anarterb/SNEStoCDi/wiring.jpg

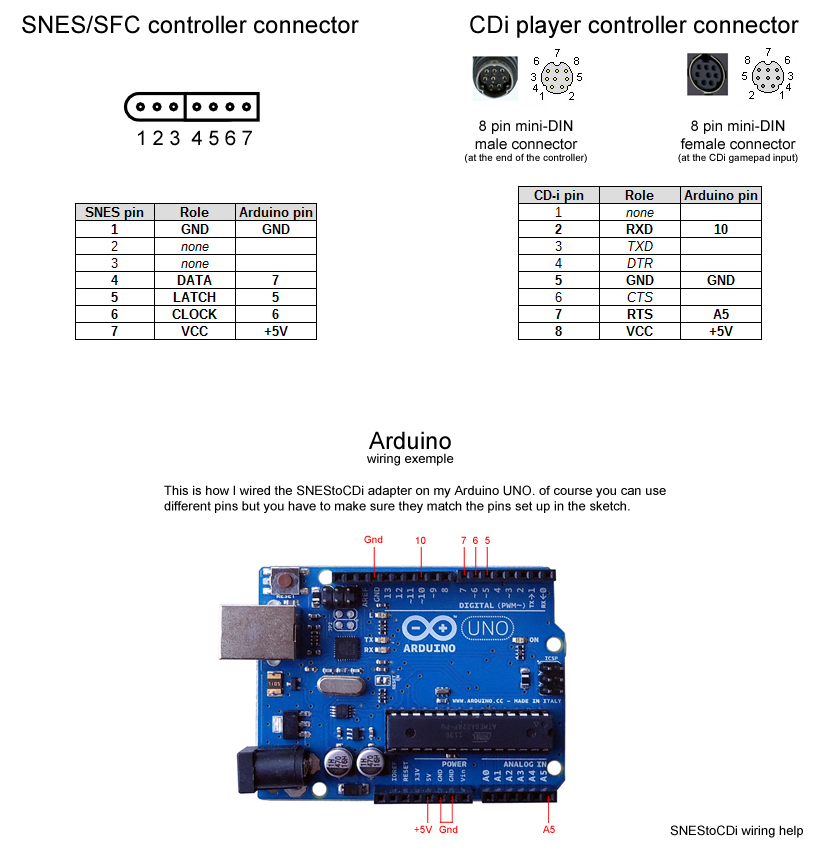
wiring.jpg
