anarterb/SNEStoCDi/(threads)

Thread 1 (2022-03-21):

Snes to cdi pad no funciona

breolou, 2022-03-21:
Hola, me llamo Breogán.
He intentado fabricar un adaptador de snes pd para la philips cdi, el caso es que no funciona... Lo he intentado varias veces, he repasado el cableado y parece que está todo bien.
Soy nuevo con el Arduino y no sé donde puede estar el error.
Un saludo y gracias.

pasmoi87, 2023-04-22:
Hello,
I have made a SNES2CDI with Arduino Pro Mini and It not works on CDI 470 and works on my CDI 210.
I made another for a guy who has a CDI 210 and it not works ?
Any ideas ?
I have also made a version RF, I will test them when I receive my Arduinos 3,3V.
Thanks.
