anarterb/SNEStoCDi/sketchSNEStoCDi.ino

/*******************************
 *
 *  File: sketchSNEStoCDi.ino
 *  Description: software for the SNEStoCDi gamepad converter (allows to use a Nintendo SNES/SFC gamepad on a Philips CDi)
 *  Author: Laurent Berta
 *  Date: 03-21-2016
 *  Version: 0.2
 *  Thanks: Rob Duarte (SNESpad library), Paul Hackmann (documentation about the CDi pointing devices)
 *  License: CC-BY 4.0 ( http://creativecommons.org/licenses/by/4.0/legalcode )
 *
 ******************************/

#include <SoftwareSerial.h>
#include <SNESpad.h>
#include <EEPROM.h>

SNESpad pad = SNESpad(5, 6, 7); // Create a SNESpad instance, change the pin values to match your wiring (latch, clock, data)
SoftwareSerial vSerial(9, 10, true); // RX, TX, inverse_logic. RX is not used here, as the CDi only communicates on the RTS line
const int RTSpin = 5; // the number of the analog pin used to receive the RTS signal from the CDi
const int ledPin = 13; // the number of the inboard LED pin

const int RTSthreshold = 328; // threshold for the CDi RTS analog detection
uint16_t btns;
bool btnRpressed = false;
int padbyte0, padbyte1, padbyte2, oldpadbyte0, oldpadbyte1, oldpadbyte2, x, y;
byte spd;
bool firstId = true;
bool btnLpressed = false;
bool btnSEpressed = false;
bool standardMapping = true;

// init
void setup()
{
  oldpadbyte0 = 0;
  oldpadbyte1 = 0;
  oldpadbyte2 = 0;

  byte eepromData = EEPROM.read(0); // retrieve speed setting from the Arduino's EEPROM
  if(eepromData >= 1 && eepromData <= 5) spd = eepromData;
  else spd = 3;
  
  pinMode(ledPin, OUTPUT);
  vSerial.begin(1200); // open serial interface to send data to the CDi
}

// main
void loop()
{
  if(!assertRTS()) {
    digitalWrite(ledPin, HIGH);
    while(!assertRTS()) { } // wait for CDi to assert the RTS line
    if(firstId) delay(100);
    else delay(1);
    firstId = false;
    vSerial.write(0b11001010); // send device id ("maneuvering device")
  }
  digitalWrite(ledPin, LOW);

	// Get the state of the SNES pad buttons
	btns = pad.buttons();

  // manage speed control
  if(btns & SNES_R) {
    if(!btnRpressed) changeSpeed(spd+1); // speed : up
    btnRpressed = true;
  }
  else btnRpressed = false;
  if(btns & SNES_L) {
    if(!btnLpressed) changeSpeed(spd-1); // speed : down
    btnLpressed = true;
  }
  else btnLpressed = false;
  if(btns & SNES_START) changeSpeed(3); // speed : default (3)

  padbyte0 = 0b11000000;  //initialize data bytes
  padbyte1 = 0b10000000;
  padbyte2 = 0b10000000;

  // Dpad X axis
  x = 127;
  if(btns & SNES_LEFT) x = 254;
  if(btns & SNES_RIGHT) x = 1;
  x = adjustSpeed(x);
  
  if(x<127) // right
  {
    x = x ^ 0b01111111;
    x = x + 1;
    padbyte1 = padbyte1 | x;
    padbyte1 = padbyte1 & 0b10111111;
    if((x & 0b01000000) != 0)
      padbyte0 = padbyte0 | 0b00000001;
  }
  else if(x>127) // left
  {
    x = x ^ 0b01111111;
    x = x + 1;
    padbyte1 = padbyte1 | x;
    padbyte1 = padbyte1 & 0b10111111;
    if((x & 0b01000000) != 0)
      padbyte0 = padbyte0 | 0b00000011;
    else
      padbyte0 = padbyte0 | 0b00000010; 
  }

  // Dpad Y axis
  y = 127;
  if(btns & SNES_UP) y = 254;
  if(btns & SNES_DOWN) y = 1;
  y = adjustSpeed(y);

  if(y<127) // down
  {
    y = y ^ 0b01111111;
    y = y + 1;
    padbyte2 = padbyte2 | y;
    padbyte2 = padbyte2 & 0b10111111;
    if((y & 0b01000000) != 0)
      padbyte0 = padbyte0 | 0b00000100;
  }
  else if(y>127) // up
  {
    y = y ^ 0b01111111;
    y = y + 1;
    padbyte2 = padbyte2 | y;
    padbyte2 = padbyte2 & 0b10111111;
    if((y & 0b01000000) != 0)
      padbyte0 = padbyte0 | 0b00001100;
    else
      padbyte0 = padbyte0 | 0b00001000;
  }

  // buttons
  if(btns & SNES_SELECT) {
    if(!btnSEpressed) standardMapping = !standardMapping; // mapping change : invert buttons 1 & 2 (Y & B)
    btnSEpressed = true;
  }
  else btnSEpressed = false;
  if(standardMapping) {
    if(btns & SNES_Y) padbyte0 = padbyte0 | 0b00100000;  //button 1 (Y)
    if(btns & SNES_B) padbyte0 = padbyte0 | 0b00010000;  //button 2 (B)
  }
  else {
    if(btns & SNES_B) padbyte0 = padbyte0 | 0b00100000;  //button 1 (B)
    if(btns & SNES_Y) padbyte0 = padbyte0 | 0b00010000;  //button 2 (Y)
  }
  if((btns & SNES_X) || (btns & SNES_A)) padbyte0 = padbyte0 | 0b00110000; // button 3 (A or X)

  if((padbyte0 != oldpadbyte0) || (padbyte1 != 0b10000000) || (padbyte2 != 0b10000000) || ((padbyte0 & 0b00001111) != 0))  // see if state has changed
  {     
    if(assertRTS()) vSerial.write(padbyte0);
    if(assertRTS()) vSerial.write(padbyte1);
    if(assertRTS()) vSerial.write(padbyte2);
  }

  // save state
  oldpadbyte0 = padbyte0; 
  oldpadbyte1 = padbyte1;
  oldpadbyte2 = padbyte2;
}

// true if RTS asserted
bool assertRTS() {
  if(analogRead(RTSpin) < RTSthreshold) return false;
  else return true;
}

// send back the correct Dpad value depending on the speed setting
int adjustSpeed(int val)
{
  if(val==127 || spd==5) return val;

  if(val==254) {
    if(spd==4) return 202;
    if(spd==3) return 170;
    if(spd==2) return 149;
    if(spd==1) return 130;
  }
  else {
    if(spd==4) return 53;
    if(spd==3) return 85;
    if(spd==2) return 106;
    if(spd==1) return 125;
  }
}

// change speed setting and save it to the EEPROM
void changeSpeed(byte newspeed)
{
  if(newspeed<1) newspeed=1;
  else if(newspeed>5) newspeed=5;
  
  spd=newspeed;
  EEPROM.write(0, spd);
}
