anarterb/SNEStoCDi/(commit log)

2016-03-19 Added files via upload
    SNESpaduino is a library created by Damon Dransfeld under Creative Common CC-BY-SA 3.0 licence
    website : http://en.tacticalcode.de/2013/06/snespaduino-super-nintendo-gamepad-for-arduino.html
2016-03-19 Added files via upload
    what you will find in this archive :
    - the Zip file is provided by Paul Hackmann who made a CDi interface with a PIC16C710/PIC16C715.
    - there is some very useful documentation about CDi pointing devices and the protocol used.
    - there is also Paul's schematics and code for his own CDi gamepad interface.
    - the Jpg file shows the CDi pad pinout.
2016-03-20 Added files via upload
    SNEStoCDi wiring help, shows how to connect the SNES/SFC and CDi connectors to the Arduino.
2016-04-07 Arduino sketch (source file)
